RolandThsive/Window-Roller/README.md

<div align="center">

# Engineered Window Rollers
### *FEM-verified replacement rollers for aluminium-profile sliding windows*

Engineered Window Rollers










</div>

---

## Overview

A project by [@RolandThsive](https://ro-h-bots.blogspot.com/p/about-me.html).

The rollers that came with my sliding windows kept failing — they deformed and cracked around the screws and the pulley holder under the weight of the glass. So I redesigned them from scratch: the weak spots are reinforced, the pulley runs on a sealed **SKF 626-2RSH** bearing, and every load-bearing part was checked with **Finite Element Analysis** before it was printed.

Each window pane weighs **10 kg** and rides on two symmetrically placed rollers, so each roller carries about **5 kg**. A spring-loaded pulley retracts for installation, and the roller screws in from the side so the pulley drops into the window's slot.

---

## Features

- **Reinforced where the originals failed** — around the screws and the pulley holder
- **SKF 626-2RSH sealed bearing** for smooth, quiet, long-lasting rolling
- **Hardened stainless-steel dowel pins** as axles instead of plastic pegs
- **Spring-loaded, retractable pulley** for easy installation and constant contact with the track
- **FEM-verified** in FreeCAD and ParaView — under 40 µm of deflection at full static load
- Printed solid — **PETG, 100% infill**

---

## Gallery

<div align="center">

| Full Assembly | Full Assembly — 3D Model |
| :---: | :---: |
| Full Assembly | Full Assembly 3D model |

*Want to spin it around? The blog post has an interactive 3D view of the full assembly.*

</div>

---

## Finite Element Analysis

Both printed load-bearing parts were analysed under static load in **FreeCAD FEM** (CalculiX) and post-processed in **ParaView**.

<div align="center">

| Free Body Diagram | Base Body — Forces & Constraints |
| :---: | :---: |
|  |  |
| **Undeformed Displacement — Base Body** | **Undeformed Displacement — Pulley Holder** |
| Undeformed Displacement - Base Body | Undeformed Displacement - Pulley Holder |

</div>

| Load case | Value |
| :--- | :--- |
| Load along Y | 50 N |
| Load along X | 68 N |

| Part | Max deflection (static) |
| :--- | :---: |
| Base Body | ~35 µm |
| Pulley Holder | ~17 µm |

The raw CalculiX results (`.vtu`) are in [`FreeCAD Files/Results_VTK_FREECAD/`](FreeCAD%20Files/Results_VTK_FREECAD) — open them in ParaView to explore the stress and displacement fields yourself. Dynamic load testing is next.

---

## Instructions

For the full write-up, FEM results and the interactive 3D model, head to the official blog post:
[Engineered Window Rollers](https://ro-h-bots.blogspot.com/2026/07/engineered-window-rollers.html)

### Printing

| Setting | Value |
| :--- | :--- |
| Material | PETG |
| Infill | 100% |
| Orientation | Top side down on the plate |

The printable parts are in [`Printables/`](Printables) as STEP files — import them straight into your slicer.

### Installing

1. Retract the pulley against its spring.
2. Slide the roller into place and screw it in from the side.
3. Let the pulley go — it engages the window's slot.

> [!TIP]
> Each pane needs **two** rollers. The BOM below is for **one** roller — double it per pane.

---

## Bill of Materials (BOM)

*Per roller.*

| Quantity | Item Description |
| :---: | :--- |
| **1x** | M5 x 35 mm Hex Head Allen Type Screw |
| **1x** | M5 Square Nut |
| **2x** | M5 Washer |
| **1x** | 8mm OD and 5mm ID Spring |
| **1x** | M3 x 25mm CSK Torx Screw |
| **1x** | M3 x 12mm StandOff |
| **1x** | SKF 626 - 2RSH Bearing |
| **1x** | M6 x 12mm Hardened SS Dowel Pin |
| **2x** | M2 x 12mm Hardened SS Dowel Pin |
| **1 Set** | 3D Printed Components - SET = BaseBody, Pulley and Pulley Holder |
| **1x** | B7000 Glue |

---

## Tools Required

| Tool | Description |
| :---: | :--- |
| **1x** | PB Swiss Allen type 4mm Hex Driver |
| **1x** | PB Swiss Torx type 8 Torx Driver |
| **1x** | Gressel/Proxxon 75mm Bench Vice |
| **1x** | A Set of Utility Tweezers |
| **1x** | Human Hands |

---

## Repository Structure

```
Window-Roller/
├── FreeCAD Files/
│   ├── FullAssembly.FCStd          # Complete assembly
│   ├── BaseBody.FCStd              # Printed parts
│   ├── PulleyHolder.FCStd
│   ├── Pulley.FCStd
│   ├── SKF_Bearing_626_2RSH.FCStd  # Hardware models
│   ├── 6x12_ROD.FCStd · Spring.FCStd · Standoffs.FCStd · Fastners.FCStd
│   └── Results_VTK_FREECAD/        # FEM results (.vtu) for ParaView
├── Full Assembly Step File/        # STEP of the complete assembly
├── Printables/                     # STEP files of the parts to print
├── LICENSE
└── README.md
```

---

## Connect With Me
* **Blog:** [ro-h-bots.blogspot.com](https://ro-h-bots.blogspot.com/)
* **Insta:** [@ro_h_bots](https://www.instagram.com/ro_h_bots?igsh=cDNkcnNpYnB5aWR1)

---

## License

[][cc-by-nc-sa]

This work is licensed under a [Creative Commons Attribution-NonCommercial-ShareAlike 4.0 International License][cc-by-nc-sa].

[][cc-by-nc-sa]

[cc-by-nc-sa]: http://creativecommons.org/licenses/by-nc-sa/4.0/
[cc-by-nc-sa-image]: https://licensebuttons.net/l/by-nc-sa/4.0/88x31.png
[cc-by-nc-sa-shield]: https://img.shields.io/badge/License-CC%20BY--NC--SA%204.0-lightgrey.svg

<div align="center">

Made with love by **RolandThsive ([@RolandThsive](https://github.com/RolandThsive))**

</div>
