RolandThsive/Window-Roller/Full Assembly Step File/Complete Assembly/FullAssembly_WindowRollers.step

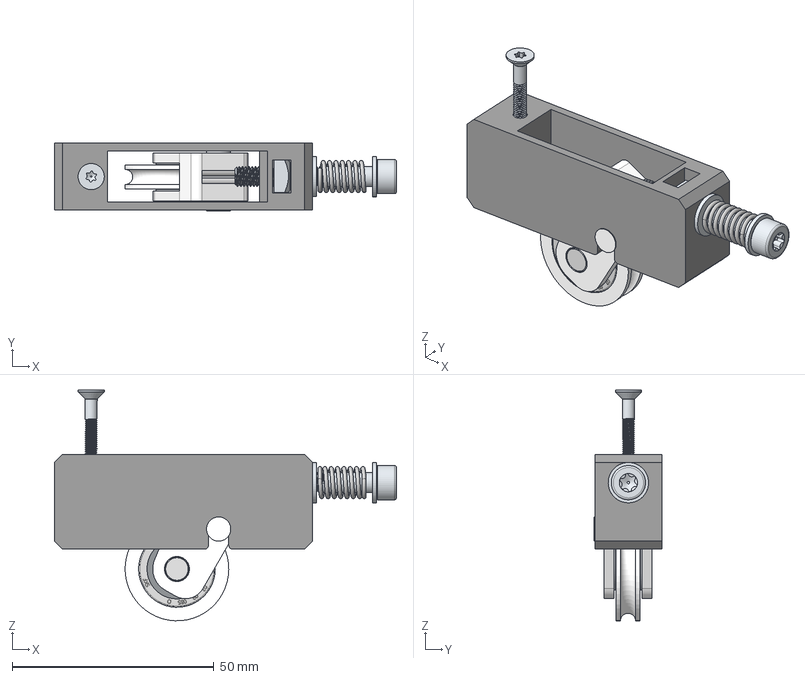
[picture p1: CAD file, 2026-08-04]
Full Assembly Step File/Complete Assembly/FullAssembly_WindowRollers.step
84.8 x 16.8 x 57.2 mm
BaseBody
PulleyHolder
Pulley
6x12_ROD
2x12_ROD x 2
M5-Nut
M5-Washer x 2
M5x35-Screw
M3x25-Screw
Spring
m3x12_Standoff
626 Ball
Seal
626 OuterCage
626 Ball001
Seal001
626 Ball002
626 Ball003
626 Ball004
626 Inner ring
626 Ball005
626 Ball006
626 Ball007
