RolandThsive/Window-Roller/Printables/BaseBody-AssemblyFillet.step

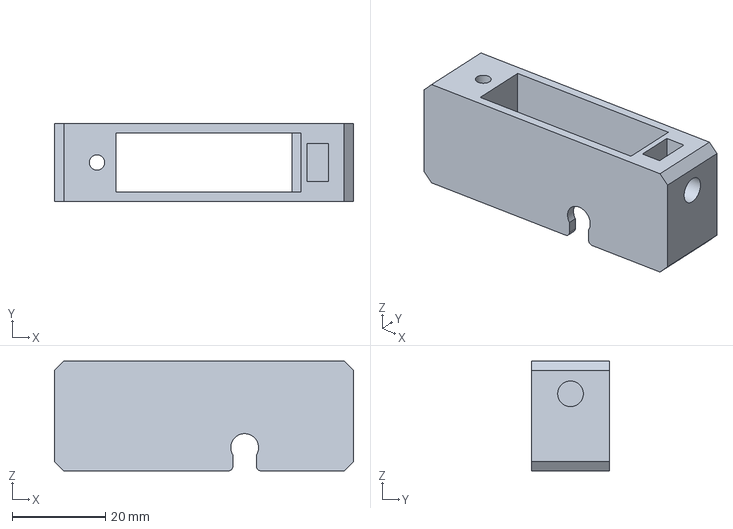
[picture p2: CAD file, 2026-08-04]
Printables/BaseBody-AssemblyFillet.step
64.0 x 16.6 x 23.5 mm
