RolandThsive/Window-Roller/FreeCAD Files/Fastners.FCStd

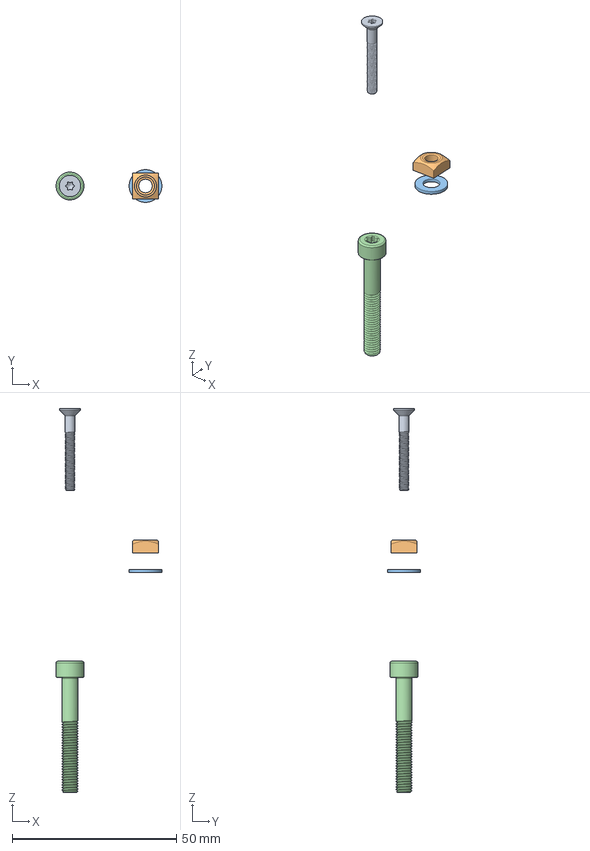
[picture p3: CAD file, 2026-08-04]
FreeCAD Files/Fastners.FCStd
32.2 x 10.00 x 117.0 mm
M3x25-Screw
M5-Nut
M5-Washer
M5x35-Screw
