RolandThsive/Window-Roller/FreeCAD Files/Pulley.FCStd

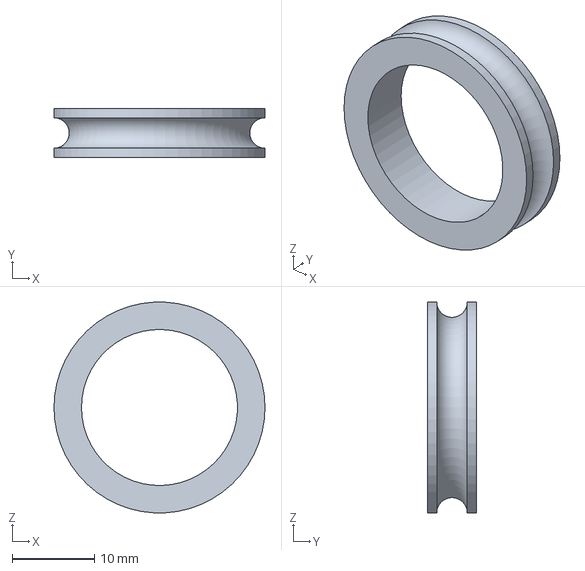
[picture p4: CAD file, 2026-08-04]
FreeCAD Files/Pulley.FCStd
25.7 x 6.00 x 25.7 mm
