RolandThsive/Window-Roller/FreeCAD Files/Standoffs.FCStd

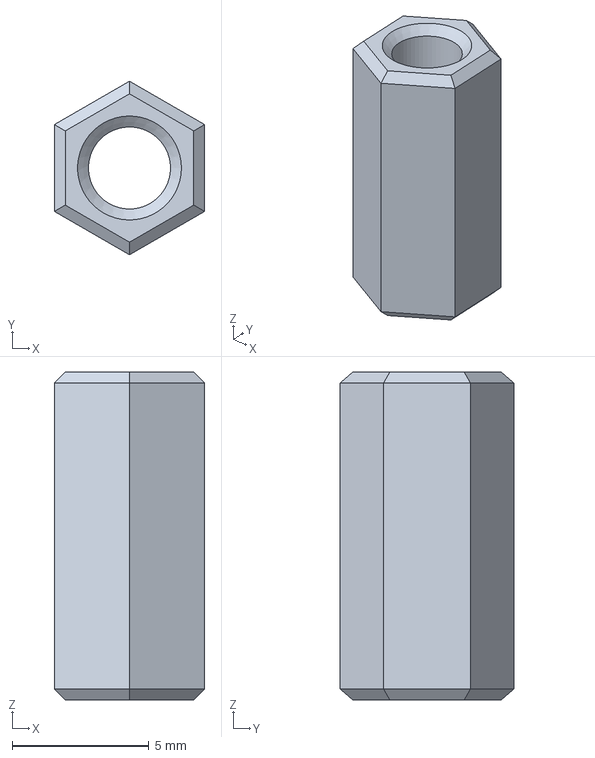
[picture p5: CAD file, 2026-08-04]
FreeCAD Files/Standoffs.FCStd
5.50 x 6.35 x 12.0 mm
