RolandThsive/Window-Roller/Printables/PulleyHolder.step

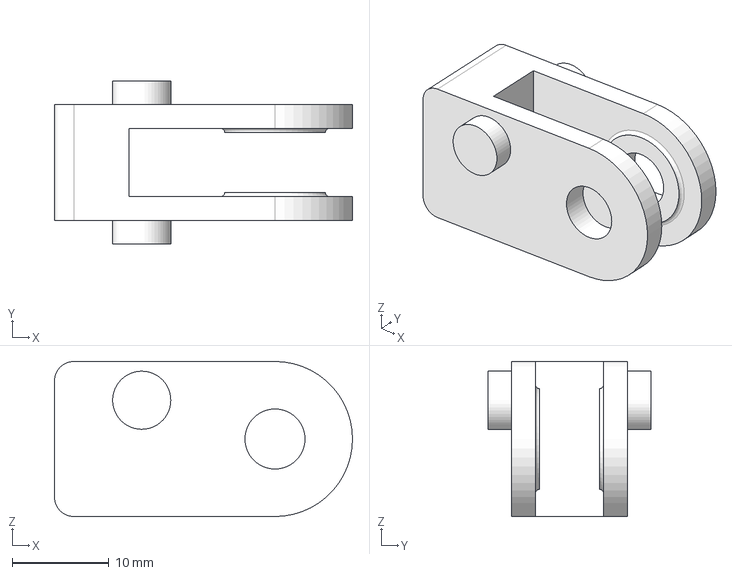
[picture p6: CAD file, 2026-08-04]
Printables/PulleyHolder.step
30.8 x 16.8 x 16.0 mm
