RolandThsive/Window-Roller/FreeCAD Files/Spring.FCStd

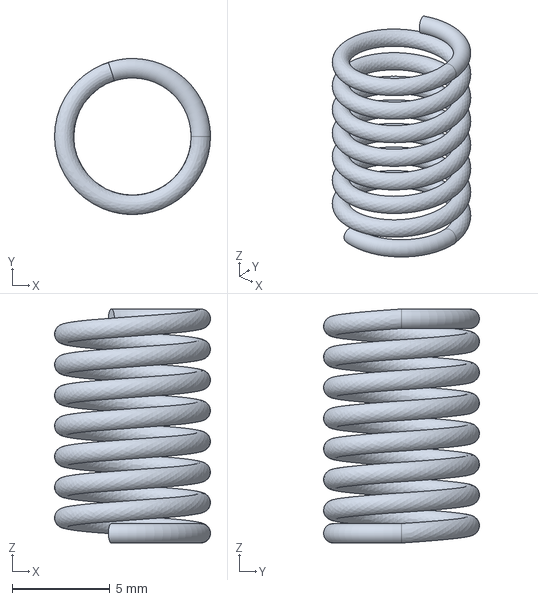
[picture p7: CAD file, 2026-08-04]
FreeCAD Files/Spring.FCStd
8.00 x 8.00 x 12.0 mm
