RolandThsive/Window-Roller/FreeCAD Files/6x12_ROD.FCStd

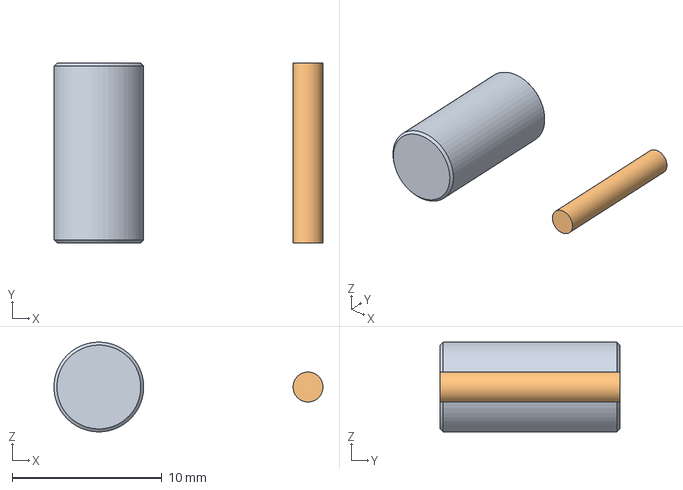
[picture p8: CAD file, 2026-08-04]
FreeCAD Files/6x12_ROD.FCStd
18.0 x 12.0 x 6.00 mm
6x12_ROD
2x12_ROD
