RolandThsive/Window-Roller/FreeCAD Files/SKF_Bearing_626_2RSH.FCStd

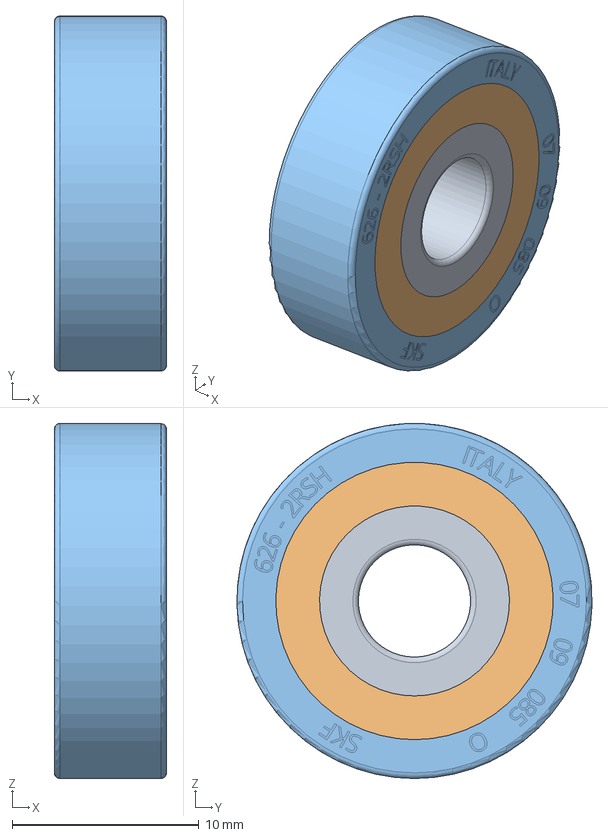
[picture p9: CAD file, 2026-08-04]
FreeCAD Files/SKF_Bearing_626_2RSH.FCStd
6.01 x 19.0 x 19.0 mm
626 Ball
Seal
626 OuterCage
626 Ball001
Seal001
626 Ball002
626 Ball003
626 Ball004
626 Inner ring
626 Ball005
626 Ball006
626 Ball007
