RolandThsive/Window-Roller/FreeCAD Files/PulleyHolder.FCStd

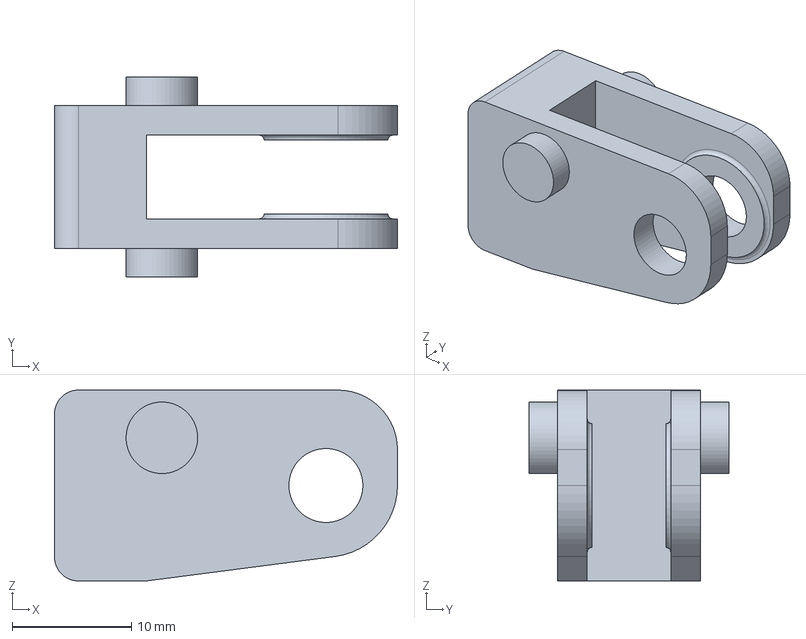
[picture p10: CAD file, 2026-08-04]
FreeCAD Files/PulleyHolder.FCStd
28.8 x 16.8 x 16.0 mm
