RolandThsive/Window-Roller/(list of files, cad)

Other CAD files:
FreeCAD Files/FullAssembly.FCStd
Printables/Pulley.step
FreeCAD Files/BaseBody.FCStd
